UTEDungNguyen/Robotics/README.md

# Robotics
Project Caro Robot with AI and Screen Controller Using Python and Arduino IDE

Link Video Youtube Demo Caro Robot : https://youtu.be/UYHZhaUiAws
