UTEDungNguyen/Robotics/ROBOTICS/Báo Cáo Cuối Kỳ Môn Kỹ Thuật Robot/Báo Cáo Môn Kỹ Thuật Robot - Nhóm KDA - Lớp Sáng Thứ 7 (Tiết 1-3).pdf

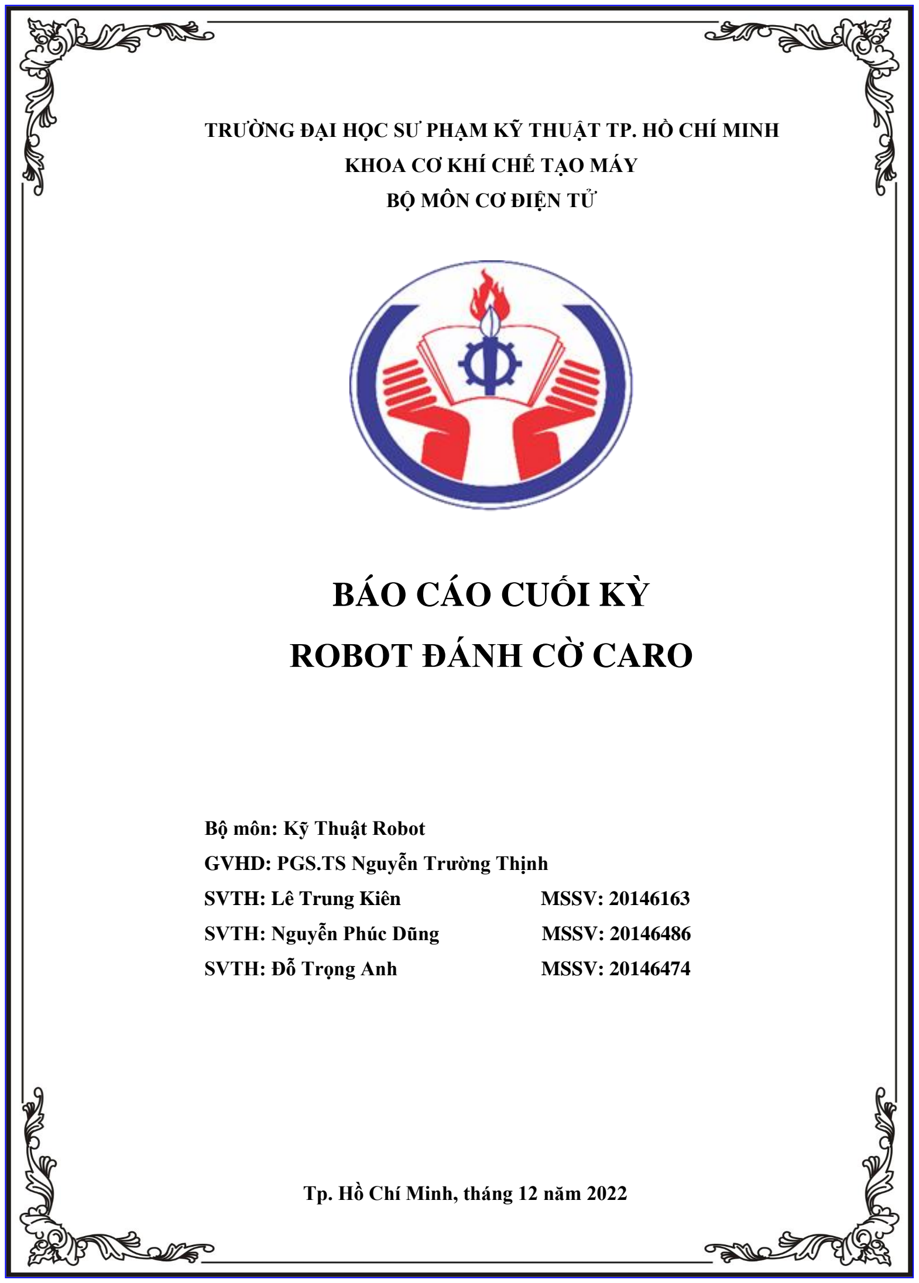
[picture p1: page 1]

TRƯỜNG ĐẠI HỌC SƯ PHẠM KỸ THUẬT TP. HỒ CHÍ MINH

KHOA CƠ KHÍ CHẾ TẠO MÁY

BỘ MÔN CƠ ĐIỆN TỬ

## BÁO CÁO CUỐI KỲ

## ROBOT ĐÁNH CỜ CARO

Bộ môn: Kỹ Thuật Robot

GVHD: PGS.TS Nguyễn Trường Thịnh

SVTH: Lê Trung Kiên | MSSV: 20146163
SVTH: Nguyễn Phúc Dũng | MSSV: 20146486
SVTH: Đỗ Trọng Anh | MSSV: 20146474

Tp. Hồ Chí Minh, tháng 12 năm 2022

Điểm số

Nhận xét

Ký tên

PGS.TS Nguyễn Trường Thịnh

## Mục lục

Tổng quan về đề tài và ý tưởng thiết kế

TÀI LIỆU THAM KHẢO

## Tổng quan đề tài

Cờ caro là một trò chơi phổ biến trên toàn thế giới bởi lối chơi đơn giản nhưng mang tính đấu trí cao. Với lịch sử phát triển lâu dài thì bộ môn cờ caro cũng có sự đa dạng trong cách chơi, từ các ô 3x3, 5x5 và các ô lớn hơn. Một ván cờ caro thường có hai người chơi thi đấu với nhau nên trò chơi có tính đối kháng và tư duy rất cao. Do vậy thiết kế và chế tạo robot đánh cờ caro được chọn làm đề tài của đồ án kỳ của bộ môn Kỹ Thuật Robot năm nay. Việc tạo ra Robot đánh caro cần sự kết hợp của nhiều thành phần như thiết kế và thi công cơ khí, sử dụng trí tuệ nhân tạo để xử lí các nước đi. Với việc được tạo sân chơi giao lưu giữa các nhóm thì đây vừa là sân chơi vừa là những bài học bổ ích cho sinh viên.

Bàn cờ thi đấu:

- Bàn cờ 3x3
- Bàn cờ 5x5

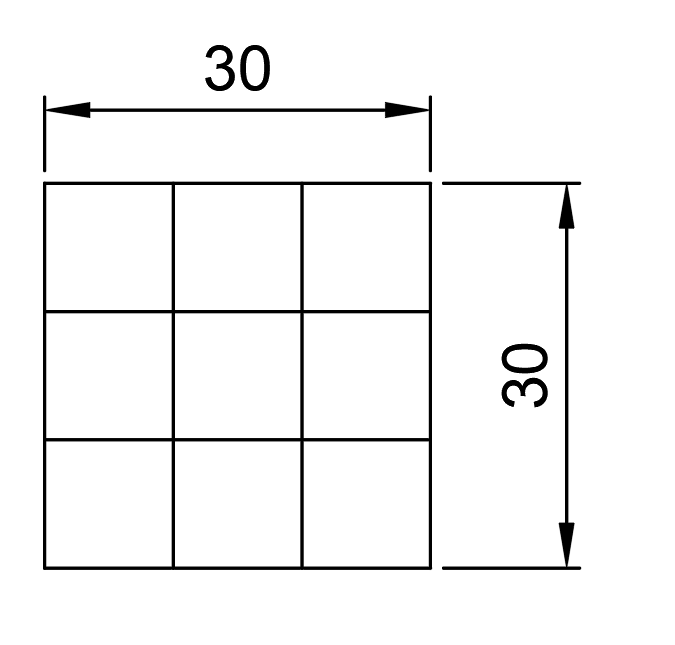
[picture p2: figure]
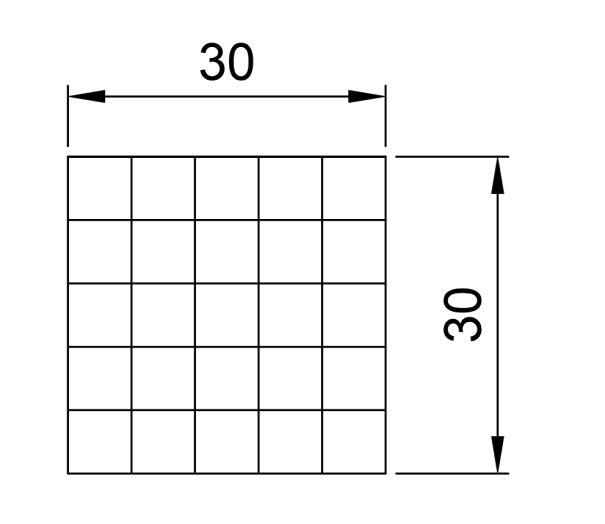
[picture p3: figure]

- Bàn cờ 7x7

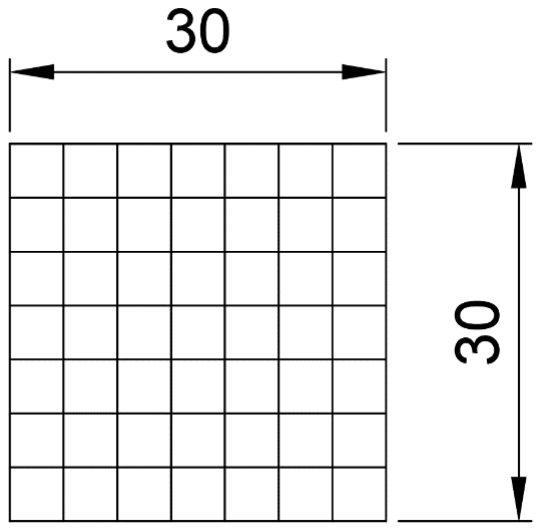
[picture p4: figure]

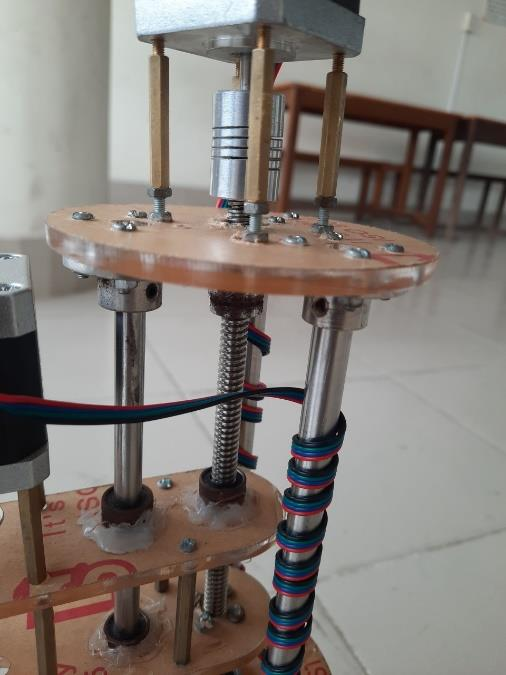
[picture p5: figure]

1

I. Nguyên lí và thiết kế Robot:

### 1.1. Nguyên lí:

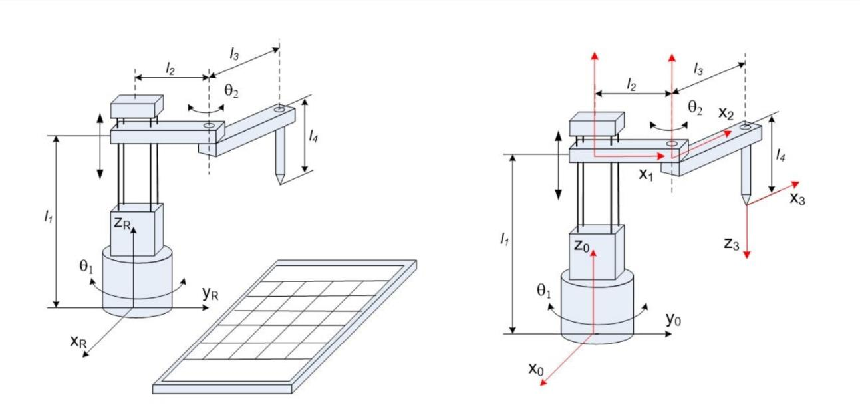
[picture p6: figure]

STT | Đặc tính | Thông số
1 | l1 | 20
2 | l2 | 25
3 | l3 | 16
4 | l4 | 14

### 1.2. Thiết kế:

- Sử dụng vật liệu mica dày 5mm gọn nhẹ định hình robot
- Các trục trơn kim loại làm cơ cấu cố định các thành phần
- Bộ truyền trục vít được ứng dụng cho trục Z
- Bước vít: 8mm/vòng
- Chiều dài trục vít: 180mm

2

- Bộ truyền đai: tỷ số truyền là 1:1 (hai pulley dẫn và bị dẫn đều có 20 răng)

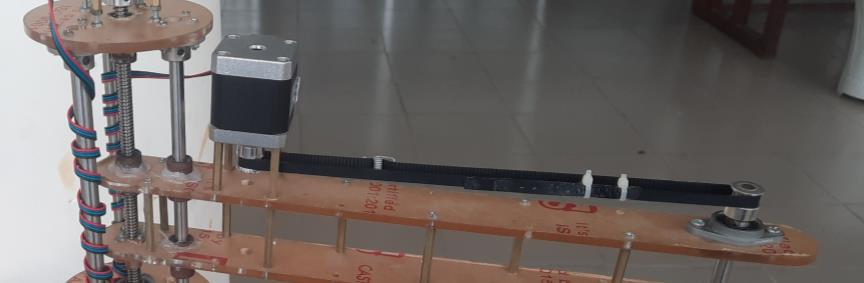
[picture p7: figure]

- Sử dụng ba Step Motor NEMA 17 size 42x40mm
- Góc bước: 1,8°/step
- Đường kính trục 5mm
- Momen xoắn: 0,45Nm

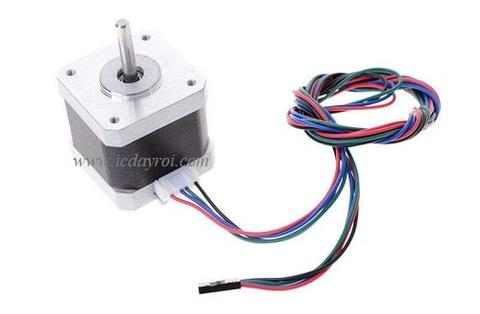
[picture p8: figure]

- Dùng ARDUINO UNO và ARDUINO CNC SHELD để điều khiển động cơ

3

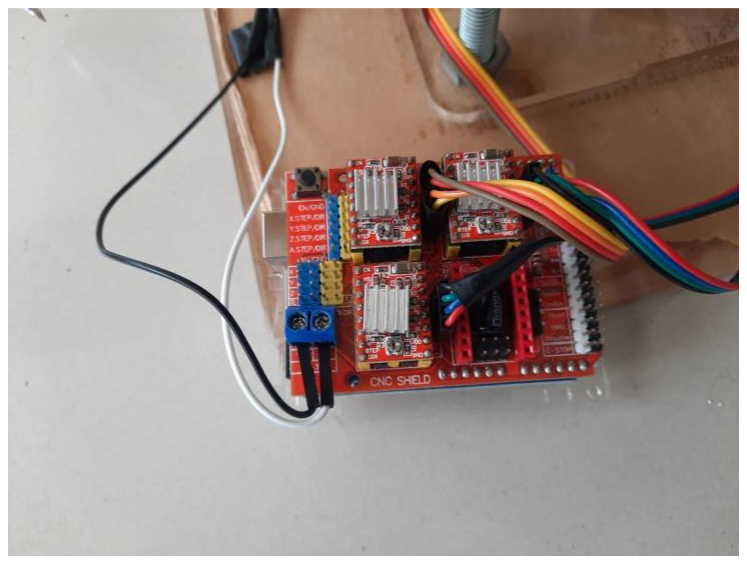
[picture p9: figure]

- Sử dụng mặt bích 10mm và bút bi gắn cố định vào cánh tay làm cơ cấu viết

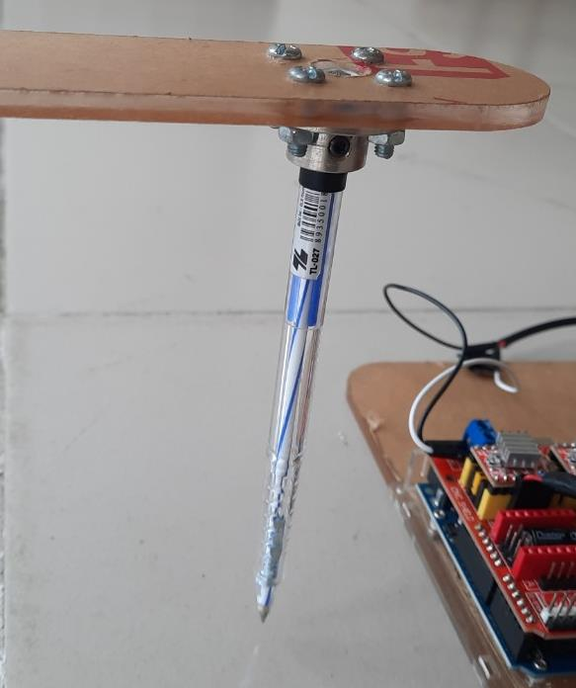
[picture p10: figure]

4

II. Thuật toán điều khiển

### 2.1. Giải các bài toán động học thuận

### 2.1.1. Bài toán động học thuận

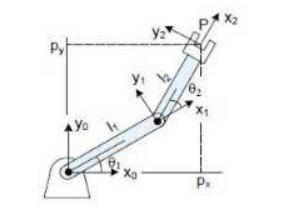
[picture p11: figure]

Bảng tham số D-H của robot :

Gọi :

c1 = cosθ1

s1 = sinθ1

c2 = cosθ2

s2 = sinθ2

c12 = cos(θ1 + θ2)

s12 = sin(θ1 + θ2

)

Ma trận chuyển vị tổng là :

0 T1 = [

c1 | − s1 | 0 | 0
s1 | c1 | 0 | 0
0 | 0 | 1 | 0
0 | 0 | 0 | 1

]

1 T2 = [

1 | 0 | 0 | l1
0 | 1 | 0 | 0
0 0 | 1 | 0
0 0 | 0 | 1

]

| θ | l | α | d
1 | θ1 | l1 | 0 | 0
2 | θ2 | l2 | 0 | 0

5

2 T3 = [

c2 | − s2 | 0 | 0
s2 | c2 | 0 | 0
0 | 0 | 1 | 0
0 | 0 | 0 | 1

]

3 T4 = [

1 | 0 | 0 | l2
0 | 1 | 0 | 0
0 | 0 | 1 | 0
0 | 0 | 0 | 1

]

Cơ cấu chấp hành cuối trong hệ trục tham chiếu :

0 T4 = [

c12 | − s12 | 0 | c12l2 + c1 l1
s12 | c12 | 0 | s12l2 + s1 l1
0 | 0 | 1 | 0
0 | 0 | 0 | 1

]

Gọi Px, Py là tọa độ vị trí cần đến :

- [

Px
Py

] = [

c12l2 + c1l1
s12l2 + s1l1

]

### 2.1.2. Bài toán động học nghịch

Từ phương trình động học vị trí :

Px = c12l2 + c1

l1

Py = s12l2 + s1

l1

cosθ1 =

Px − co s(θ1 + θ2

) l2
l1

sinθ1 =

Py − sin(θ1 + θ2

) l2
l1

→ Px

2 + Py

2 = l1

2
cosθ1

2 + l2

2
cos(θ1 + θ2

)

2 + 2l1
l2cosθ1 cos(θ1 + θ2)

= l1

2+l2
2 + 2l1
l2cosθ2

{

cosθ2 =

Px

2 + Py

2 − l1

2−l2

2
2l1

l2
sinθ2 = ±√1 − cosθ2
2

θ2 = arctan (

sinθ2
cosθ2

)
{

Px = c1

(l1 + l2c2

) + s1(−l1s2)
Py = c1

(l2s2

) + s1(l1 + l2c2)

6

[

Px
Py

] = [

l1 + l2c2 | − l2s2
l2s2 | l1 + l2c2

][

c1
s1

]

c1 =

Px | − l1s2
Py | l1 + l2c2

| X

s1 =

l1 + l2c2 | Px
l2s2 | Py

X
Px | − l1s2
Py | l1 + l2c2

| = Px
(l1 + l2c2

) + Pyl1s2
l1 + l2c2 | Px
l2s2 | Py

| = Py
(l1 + l2c2

) − Pxl2s2

tanθ1 =

Py

(l1 + l2c2

) − Pxl2s2
Px

(l1 + l2c2

) + Pyl1s2

θ1 = arctan (

s1
c1

)

### 2.1.3. Tìm ma trận Jacobi

Từ phương trình động học vị trí :

Px = c12l2 + c1

l1

Py = s12l2 + s1

l1

=> Vecto vận tốc dài :

v = [
Px

̇
Py

̇

] = [
−(s12l2 + l1s1

) − s12l2
c12l2 + c1

l1

| l2c12

][
θ1

̇
θ2

̇

] = J[
θ1

̇
θ2

̇

]

Trong J là ma trận Jacobi :

J = [

−(s12l2 + l1s1

) − s12l2
c12l2 + c1

l1

| l2c12

]

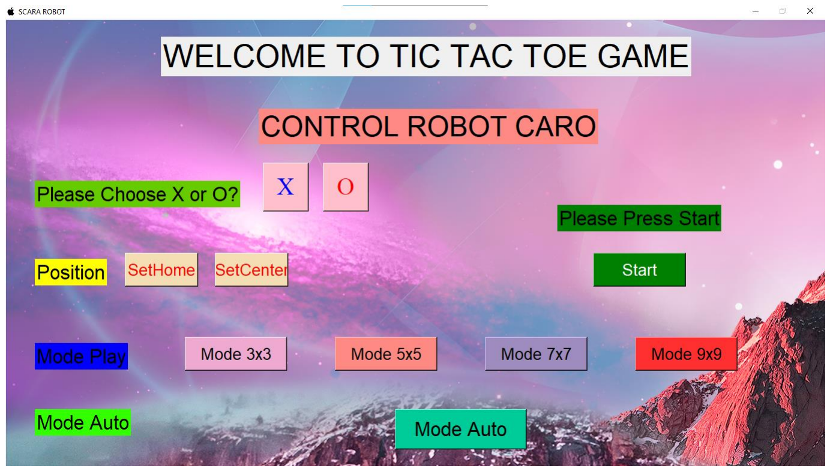
[picture p12: figure]

7

### 2.2. Code sử dụng

### 2.2.1. Code vẽ dấu X và O

Code Aruino Điều Khiển (https://drive.google.com/drive/folders/1rwQx79ox7zk-cumt7J68r_9GUzHoDtJX?usp=share_link)

### 2.2.2. Code AI

Code AI Python (https://drive.google.com/drive/folders/14FFrIaihGtB9hZXVX-wzm02s2C37sYsu?usp=share_link)

Code Aruino AI (https://drive.google.com/drive/folders/1KK_bYnLwUzkbfDp1TK2ybKO7Hr0Jon3z?usp=share_link)

### 2.2.3. Giao diện điều khiển

- Giao diện chính

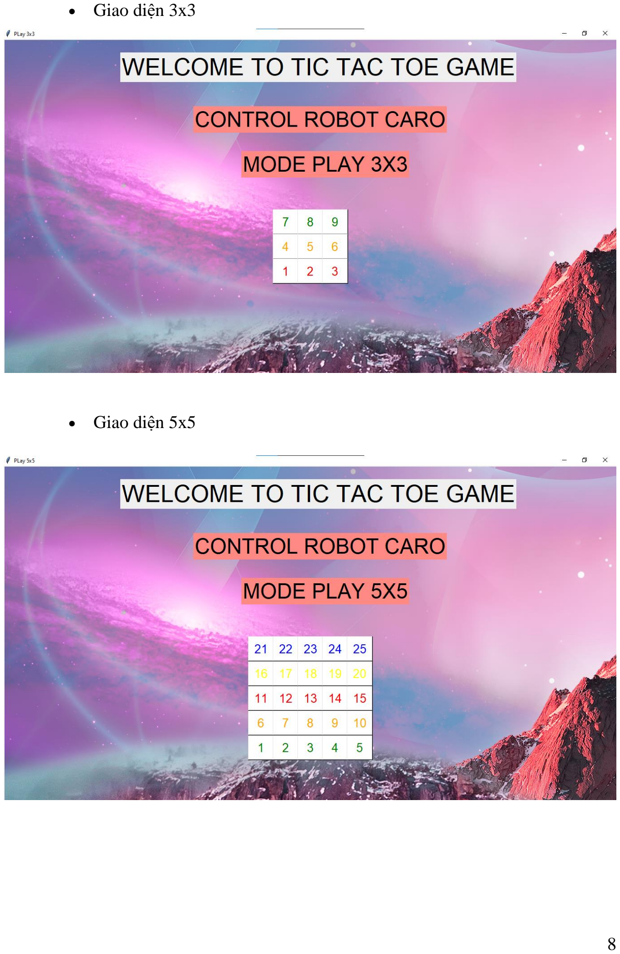
[picture p13: page 13]

8

- Giao diện 3x3
- Giao diện 5x5

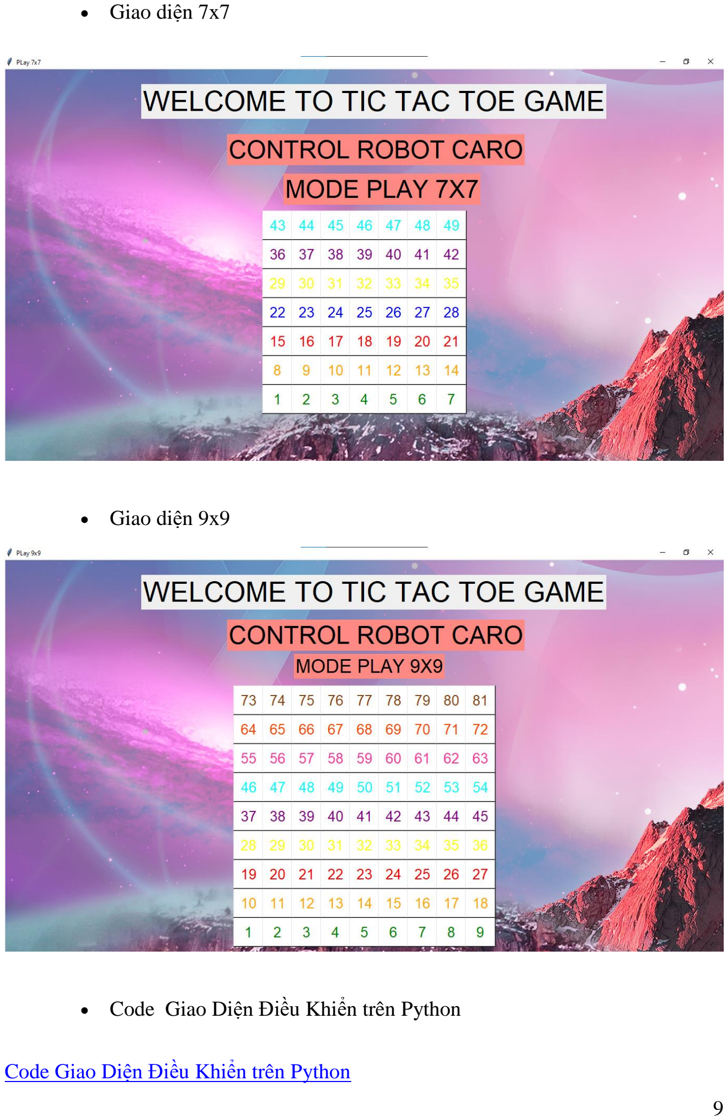
[picture p14: page 14]

9

- Giao diện 7x7
- Giao diện 9x9
- Code Giao Diện Điều Khiển trên Python

Code Giao Diện Điều Khiển trên Python (https://drive.google.com/drive/folders/1dRHWaZDvevjJNo7_DWS8d-Qamsv2Hj_F?usp=share_link)

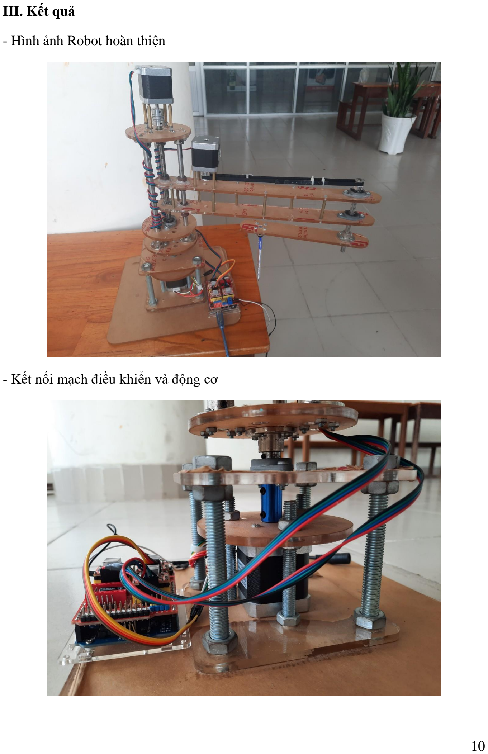
[picture p15: page 15]

10

III. Kết quả

- Hình ảnh Robot hoàn thiện
- Kết nối mạch điều khiển và động cơ

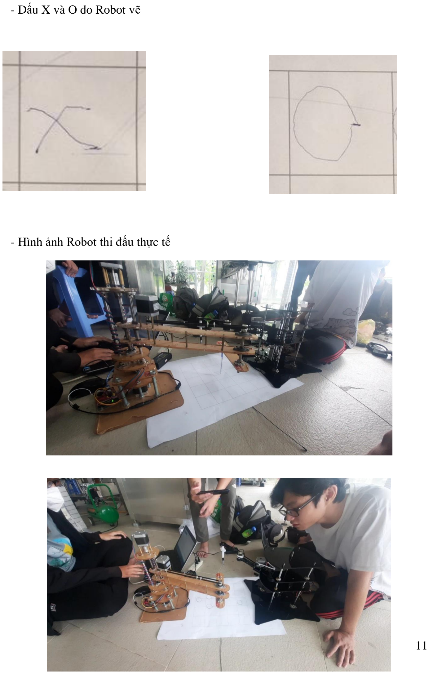
[picture p16: page 16]

11

- Dấu X và O do Robot vẽ
- Hình ảnh Robot thi đấu thực tế

12

IV. Kết luận

Nhóm đã hoàn thiện được Robot đánh caro và chạy được theo yêu cầu 3x3, 5x5, 7x7, ngoài ra còn ứng dụng thêm AI để cho Robot tự thi đấu và đạt được kết quả khá tốt.

Xây dựng được trình điều khiển dựa trên ngôn ngữ Python cho các yêu cầu.

Robot vẫn còn gặp vài lỗi trong khâu điều khiển và sai số trong di chuyển nên trong tương lai nhóm sẽ chỉnh sửa và hoàn thiện Robot hơn.

TÀI LIỆU THAM KHẢO

[1] Giáo trình Kỹ thuật robot: Phần 1 - PGS.TS. Nguyễn Trường Thịnh
